balena-io-hardware/autokit-sdMux-pcb/source/README.md

# KiCad design files

This design was created using kicad, version 6.0.5.
