balena-io-hardware/autokit-sdMux-pcb/output/3d/STEP/sd-mux.step

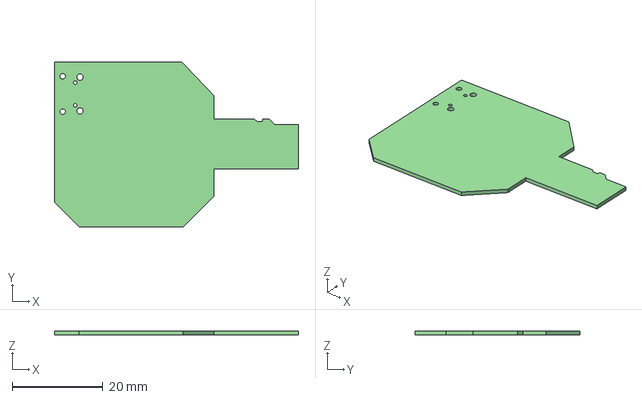
[picture p2: CAD file, 2022-07-26]
output/3d/STEP/sd-mux.step
53.7 x 36.3 x 0.825 mm
