balena-io-hardware/autokit-sdMux-pcb/testing/Testing.md

# Autokit-sd-mux testing procedure

## Test 1: Power test

- Setup: 
  - plug PCB via micro USB to PC
- Success: 
  - LED D1 lights up
- Failure:
  - LED D1 Doesn't light up

## Test 2: SD card can be toggled to usb HOST

- TBC

## Test 3: Male SD card connector fits in SD card slot of Rpi3

- TBC
