balena-io-hardware/autokit-sdMux-pcb/(commit log)

2022-05-26 intial design file commit
    Change-type: minor
    [kicad.kicad_pcb, kicad.kicad_sch]
2022-05-27 update hub reset and switch io expander to 4 pin version
    Change-type: patch
    [kicad.kicad_sch]
2022-05-31 rename files to sd-mux
    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
    [sd-mux.kicad_pcb, sd-mux.kicad_sch]
2022-05-31 add pdf of schematic
    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
    [sd-mux.kicad_sch]
2022-06-15 switch i2c to gpio for mux, add 3v3 converter
    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
    [sd-mux.kicad_sch]
2022-06-17 fixup schematic based on reviewer comments
    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
    [sd-mux.kicad_sch]
2022-06-20 add LEDs and footprints
    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
    [sd-mux.kicad_sch]
2022-07-12 add pcb layout
    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
    [sd-mux.kicad_pcb, sd-mux.kicad_sch]
2022-07-18 make first set of fixes for prototyping
    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
    [sd-mux.kicad_pcb, sd-mux.kicad_sch]
2022-07-25 finish review comments and add output files
    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
    [sd-mux-B_Cu.gbr, sd-mux-B_Mask.gbr, sd-mux-B_Paste.gbr, sd-mux-B_Silkscreen.gbr, sd-mux-Edge_Cuts.gbr, sd-mux-F_Cu.gbr, sd-mux-F_Fab.gbr, sd-mux-F_Mask.gbr]
2022-07-25 update boM
    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
    [sd-mux.csv]
2022-07-25 add part nums to BoM
    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
    [sd-mux.csv]
2022-07-25 update schematic
    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
    [sd-mux.kicad_pcb]
2022-07-26 change footprints to 0603 and add parts to bom
    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
    [sd-mux-B_Cu.gbr, sd-mux-B_Mask.gbr, sd-mux-B_Paste.gbr, sd-mux-B_Silkscreen.gbr, sd-mux-Edge_Cuts.gbr, sd-mux-F_Cu.gbr, sd-mux-F_Fab.gbr, sd-mux-F_Mask.gbr]
